gsapijaszko/datalogger/README.md

# yet another datalogger
atmega, sdcard, usb port, DS3231 RTC

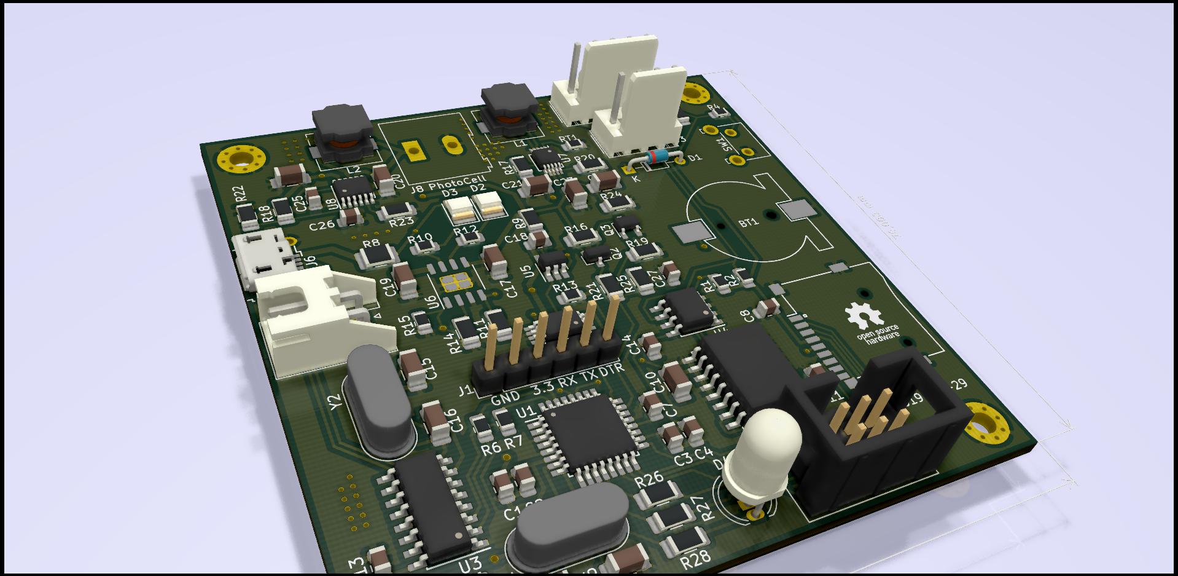
[picture p1: hardware/datalogger.jpg]


work in progress..
