gsapijaszko/datalogger/(list of files, drawings)

Other design files:
hardware/datalogger.dsn
