gsapijaszko/datalogger/hardware/datalogger.kicad_pcb

## KiCad design hardware/datalogger.kicad_pcb (2019-06-12)

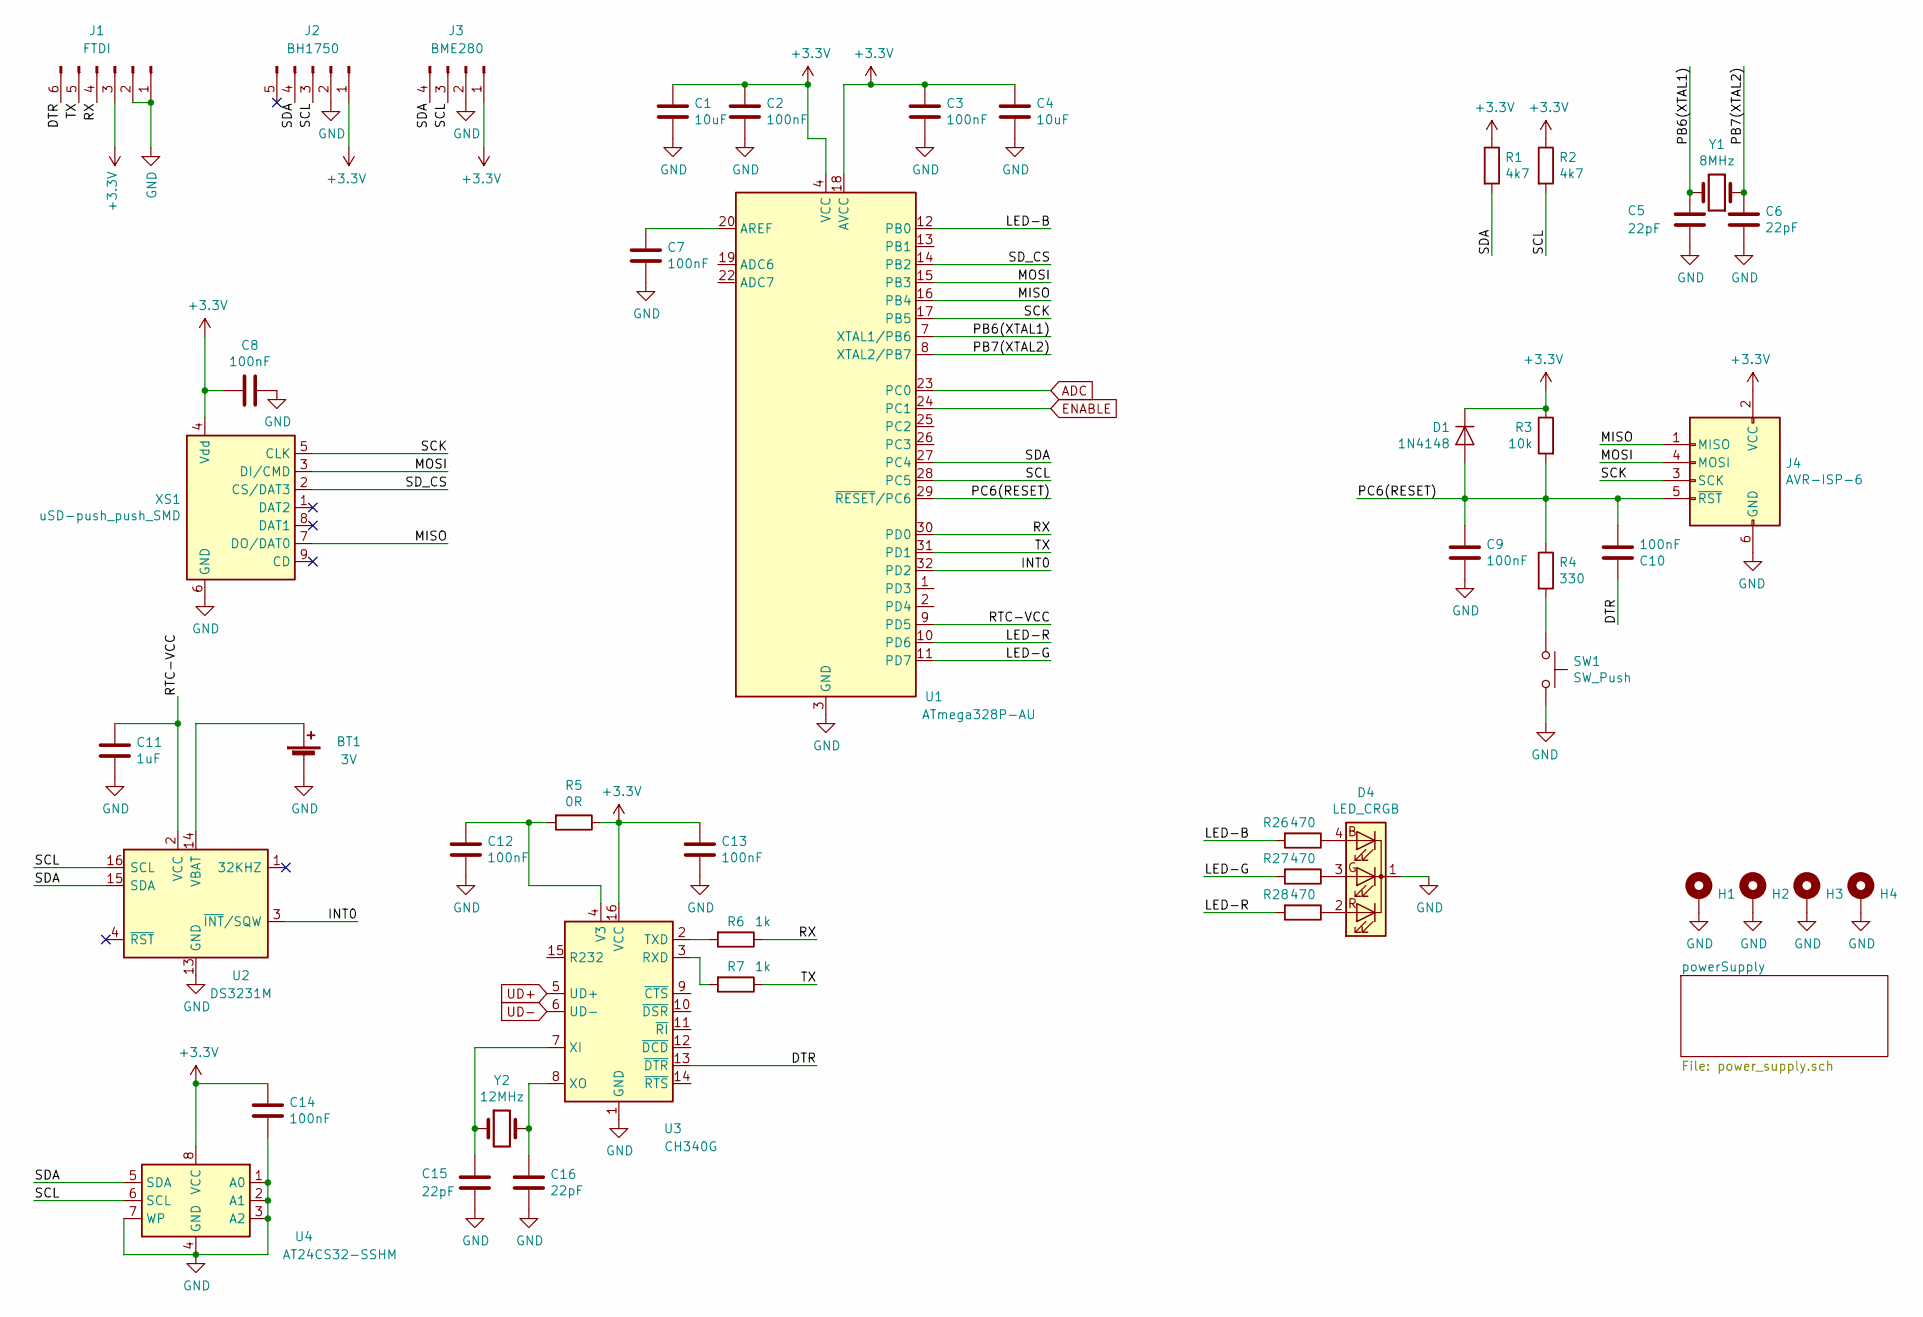
[picture p2: schematic datalogger.sch, field datalogger]

Parts:
BT1: 3V; 1220 Battery Holder, SMD
C1, C4: 10uF; C_0805_2012Metric_Pad1.15x1.40mm_HandSolder
C2, C3, C7, C8, C9, C12, C13, C14: 100nF; C_0805_2012Metric_Pad1.15x1.40mm_HandSolder
C5, C6, C15, C16: 22pF; C_1206_3216Metric_Pad1.42x1.75mm_HandSolder
C10: 100nF; C_1206_3216Metric_Pad1.42x1.75mm_HandSolder
C11: 1uF; C_0805_2012Metric_Pad1.15x1.40mm_HandSolder
D1: 1N4148; D_DO-34_SOD68_P7.62mm_Horizontal
D4: LED_CRGB; LED_D5.0mm-4_RCGB
H1, H2, H3, H4: H; MountingHole_2.7mm_M2.5_Pad_Via
J1: FTDI; PinHeader_1x06_P2.54mm_Vertical
J2: BH1750; Molex_KK-254_AE-6410-05A_1x05_P2.54mm_Vertical
J3: BME280; Molex_KK-254_AE-6410-04A_1x04_P2.54mm_Vertical
J4: AVR-ISP-6; IDC-Header_2x03_P2.54mm_Vertical
R1, R2: 4k7; R_0805_2012Metric_Pad1.15x1.40mm_HandSolder
R3: 10k; R_1206_3216Metric_Pad1.42x1.75mm_HandSolder
R4: 330; R_0805_2012Metric_Pad1.15x1.40mm_HandSolder
R5: 0R; R_0805_2012Metric_Pad1.15x1.40mm_HandSolder
R6, R7: 1k; R_0805_2012Metric_Pad1.15x1.40mm_HandSolder
R26, R27, R28: 470; R_1206_3216Metric_Pad1.42x1.75mm_HandSolder
SW1: SW_Push; SW_Tactile_SKHH_Angled
U1: ATmega328P-AU; TQFP-32_7x7mm_P0.8mm
U2: DS3231M; SOIC-16W_7.5x10.3mm_P1.27mm
U3: CH340G; SOIC-16_3.9x9.9mm_P1.27mm
U4: AT24CS32-SSHM; SOIC-8_3.9x4.9mm_P1.27mm
XS1: uSD-push_push_SMD; Conn_uSDcard
Y1: 8MHz; Crystal_HC49-U_Vertical
Y2: 12MHz; Crystal_HC49-U_Vertical

Connections:
+3V3: C1.1, C2.2, C3.2, C4.1, C8.1, C13.2, C14.1, D1.1 (K), J1.3, J2.1, J3.1, J4.2 (VCC), R1.1, R2.1, R3.1, R5.1, U1.4 (VCC), U1.6 (VCC), U1.18 (AVCC), U3.16 (VCC), U4.8 (VCC), XS1.4 (Vdd); also elsewhere on the board
/DTR: C10.1, J1.6, U3.13 (~DTR)
/INT0: U1.32 (PD2), U2.3 (~INT~/SQW)
/LED-B: R26.2, U1.12 (PB0)
/LED-G: R27.2, U1.11 (PD7)
/LED-R: R28.2, U1.10 (PD6)
/MISO: J4.1 (MISO), U1.16 (PB4), XS1.7 (DO/DAT0)
/MOSI: J4.4 (MOSI), U1.15 (PB3), XS1.3 (DI/CMD)
/PB6(XTAL1): C5.1, U1.7 (XTAL1/PB6), Y1.2
/PB7(XTAL2): C6.1, U1.8 (XTAL2/PB7), Y1.1
/PC6(RESET): C9.1, C10.2, D1.2 (A), J4.5 (~RST), R3.2, R4.1, U1.29 (~RESET~/PC6)
/RTC-VCC: C11.1, U1.9 (PD5), U2.2 (VCC)
/RX: J1.4, R6.1, U1.30 (PD0)
/SCK: J4.3 (SCK), U1.17 (PB5), XS1.5 (CLK)
/SCL: J2.3, J3.3, R2.2, U1.28 (PC5), U2.16 (SCL), U4.6 (SCL)
/SDA: J2.4, J3.4, R1.2, U1.27 (PC4), U2.15 (SDA), U4.5 (SDA)
/SD_CS: U1.14 (PB2), XS1.2 (CS/DAT3)
/TX: J1.5, R7.1, U1.31 (PD1)
ADC: U1.23 (PC0); also elsewhere on the board
ENABLE: U1.24 (PC1); also elsewhere on the board
GND: BT1.2 (-), C1.2, C2.1, C3.1, C4.2, C5.2, C6.2, C7.2, C8.2, C9.2, C11.2, C12.1, C13.1, C14.2, C15.2, C16.2, D4.1 (K), H1.1, H2.1, H3.1, H4.1, J1.1, J1.2, J2.2, J3.2, J4.6 (GND), SW1.2, U1.3 (GND), U1.5 (GND), U1.21 (GND), U2.5 (GND), U2.6 (GND), U2.7 (GND), U2.8 (GND), U2.9 (GND), U2.10 (GND), U2.11 (GND), U2.12 (GND), U2.13 (GND), U3.1 (GND), U4.1 (A0), U4.2 (A1), U4.3 (A2), U4.4 (GND), U4.7 (WP), XS1.6 (GND); also elsewhere on the board
unnamed: BT1.1 (+), U2.14 (VBAT)
unnamed: C7.1, U1.20 (AREF)
unnamed: C12.2, R5.2, U3.4 (V3)
unnamed: C15.1, U3.7 (XI), Y2.1
unnamed: C16.1, U3.8 (XO), Y2.2
unnamed: D4.2 (RA), R28.1
unnamed: D4.3 (GA), R27.1
unnamed: D4.4 (BA), R26.1
unnamed: R4.2, SW1.1
unnamed: R6.2, U3.2 (TXD)
unnamed: R7.2, U3.3 (RXD)
UD+: U3.5 (UD+); also elsewhere on the board
UD-: U3.6 (UD-); also elsewhere on the board

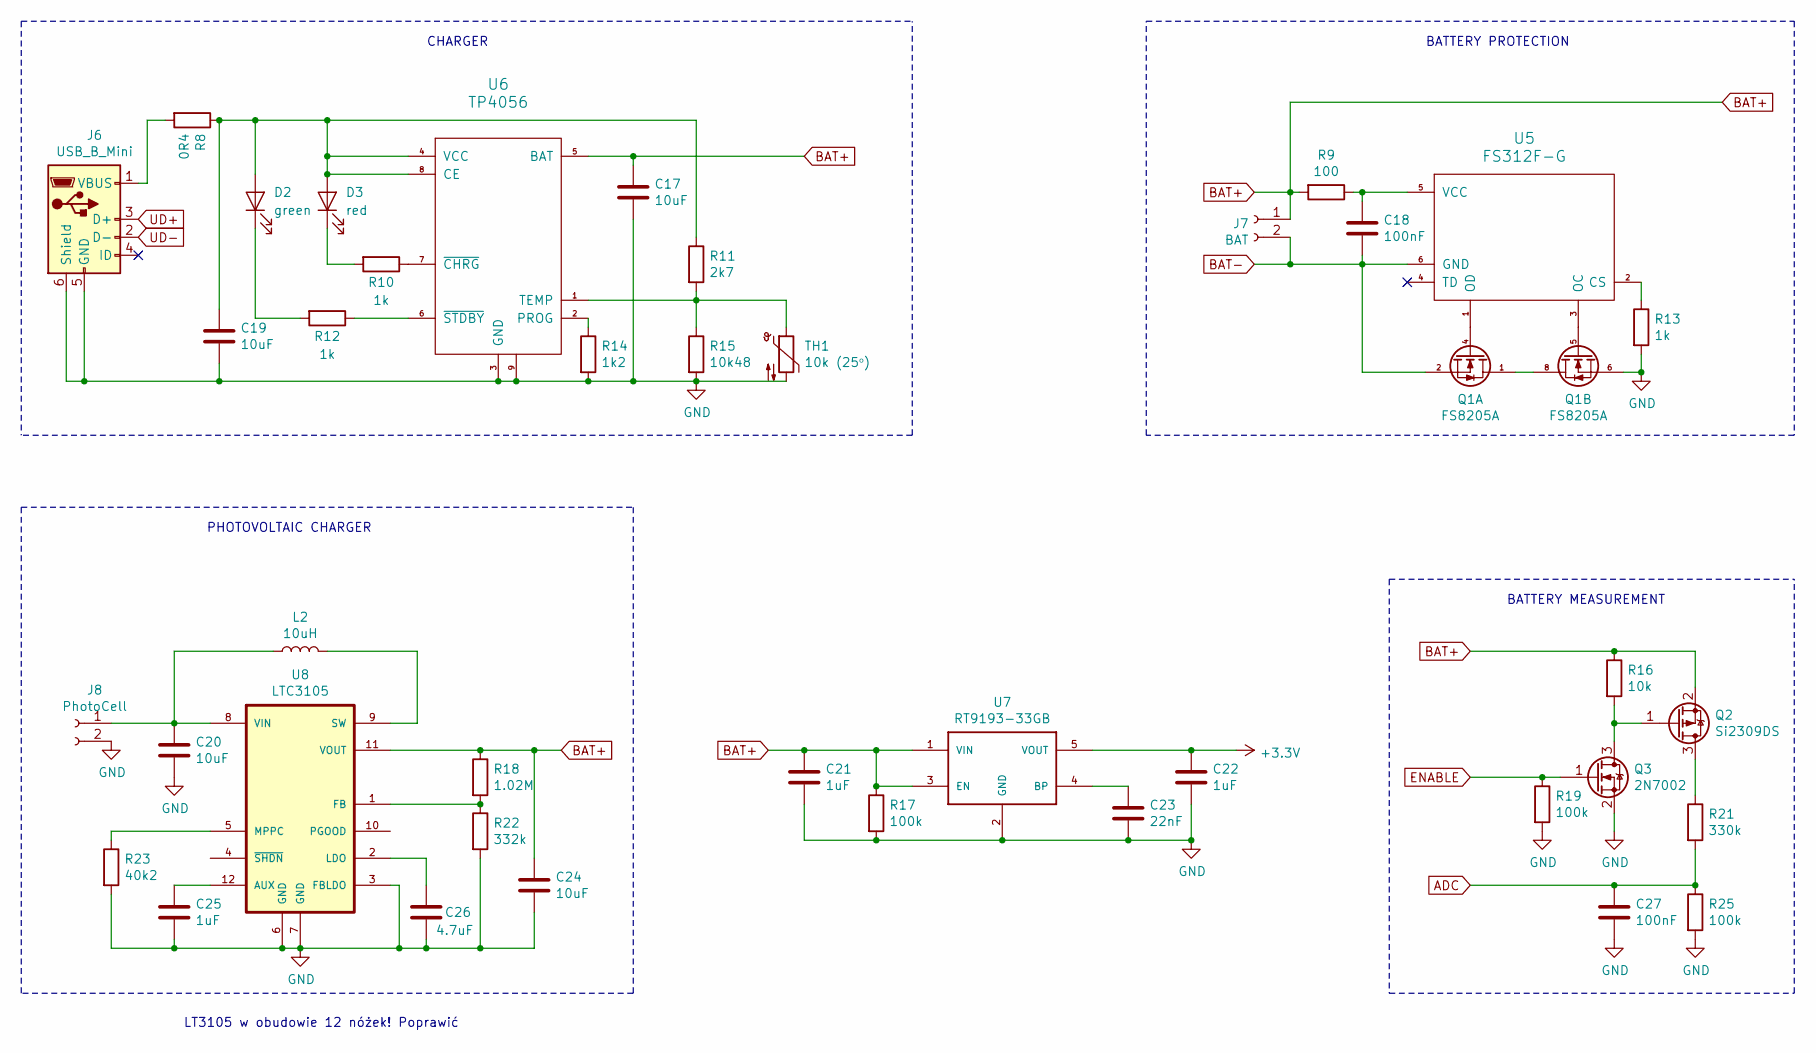
[picture p3: schematic power_supply.sch, field datalogger]

Parts:
C17, C19, C20, C24: 10uF; C_1206_3216Metric_Pad1.42x1.75mm_HandSolder
C18, C27: 100nF; C_0805_2012Metric_Pad1.15x1.40mm_HandSolder
C21, C22: 1uF; C_0805_2012Metric_Pad1.15x1.40mm_HandSolder
C23: 22nF; C_0805_2012Metric_Pad1.15x1.40mm_HandSolder
C25: 1uF; C_0805_2012Metric
C26: 4.7uF; C_0805_2012Metric
D2: green; LED_1210_3225Metric_Pad1.42x2.65mm_HandSolder
D3: red; LED_1210_3225Metric_Pad1.42x2.65mm_HandSolder
J6: USB_B_Mini; USB_Micro-B_Wuerth_629105150521
J7: BAT; JST_XH_S02B-XH-A_1x02_P2.50mm_Horizontal
J8: PhotoCell; TerminalBlock_Altech_AK300-2_P5.00mm
L2: 10uH; L_7.3x7.3_H4.5
Q1: FS8205A; TSSOP-8_4.4x3mm_P0.65mm
Q2: Si2309DS; SOT-23
Q3: 2N7002; TSOT-23
R8: 0R4; R_1210_3225Metric_Pad1.42x2.65mm_HandSolder
R9: 100; R_1206_3216Metric_Pad1.42x1.75mm_HandSolder
R10, R12, R13: 1k; R_0805_2012Metric_Pad1.15x1.40mm_HandSolder
R11: 2k7; R_1206_3216Metric_Pad1.42x1.75mm_HandSolder
R14: 1k2; R_1206_3216Metric_Pad1.42x1.75mm_HandSolder
R15: 10k48; R_0805_2012Metric_Pad1.15x1.40mm_HandSolder
R16: 10k; R_1206_3216Metric_Pad1.42x1.75mm_HandSolder
R17, R19, R25: 100k; R_1206_3216Metric_Pad1.42x1.75mm_HandSolder
R18: 1.02M; R_1206_3216Metric_Pad1.42x1.75mm_HandSolder
R21: 330k; R_1206_3216Metric_Pad1.42x1.75mm_HandSolder
R22: 332k; R_1206_3216Metric_Pad1.42x1.75mm_HandSolder
R23: 40k2; R_1206_3216Metric_Pad1.42x1.75mm_HandSolder
TH1: 10k (25ᵒ); R_1218_3246Metric_Pad1.22x4.75mm_HandSolder
U5: FS312F-G; SOT-23-6_Handsoldering
U6: TP4056; HSOP-8-1EP_3.9x4.9mm_P1.27mm_EP2.41x3.1mm_ThermalVias
U7: RT9193-33GB; SOT-23-5_HandSoldering
U8: LTC3105; MSOP-12_3x4mm_P0.65mm

Connections:
+3V3: C22.1, U7.5 (VOUT); also elsewhere on the board
ADC: C27.1, R21.2, R25.1; also elsewhere on the board
BAT+: C17.1, C21.1, C24.1, J7.1, Q2.2 (S), R9.2, R16.1, R17.1, R18.1, U6.5 (BAT), U7.1 (VIN), U7.3 (EN), U8.11 (VOUT)
BAT-: C18.2, J7.2, Q1.2 (S1), U5.6 (GND)
ENABLE: Q3.1 (G), R19.1; also elsewhere on the board
GND: C17.2, C19.2, C20.2, C21.2, C22.2, C23.2, C24.2, C25.2, C26.2, C27.2, J6.5 (GND), J6.6 (Shield), J8.2, Q1.6 (S1), Q3.2 (S), R13.2, R14.2, R15.2, R17.2, R19.2, R22.2, R23.2, R25.2, TH1.2, U6.3 (GND), U6.9, U7.2 (GND), U8.3 (FBLDO), U8.6 (GND), U8.7 (GND); also elsewhere on the board
unnamed: C18.1, R9.1, U5.5 (VCC)
unnamed: C19.1, D2.2 (A), D3.2 (A), R8.1, R11.1, U6.4 (VCC), U6.8 (CE)
unnamed: C20.1, J8.1, L2.1, U8.8 (VIN)
unnamed: C23.1, U7.4 (BP)
unnamed: C25.1, U8.12 (AUX)
unnamed: C26.1, U8.2 (LDO)
unnamed: D2.1 (K), R12.2
unnamed: D3.1 (K), R10.2
unnamed: J6.1 (VBUS), R8.2
unnamed: L2.2, U8.9 (SW)
unnamed: Q1.1 (D), Q1.8 (D)
unnamed: Q1.4 (G2), U5.1 (OD)
unnamed: Q1.5 (G2), U5.3 (OC)
unnamed: Q2.1 (G), Q3.3 (D), R16.2
unnamed: Q2.3 (D), R21.1
unnamed: R10.1, U6.7 (~CHRG)
unnamed: R11.2, R15.1, TH1.1, U6.1 (TEMP)
unnamed: R12.1, U6.6 (~STDBY)
unnamed: R13.1, U5.2 (CS)
unnamed: R14.1, U6.2 (PROG)
unnamed: R18.2, R22.1, U8.1 (FB)
unnamed: R23.1, U8.5 (MPPC)
UD+: J6.3 (D+); also elsewhere on the board
UD-: J6.2 (D-); also elsewhere on the board

Notes on the sheet:
CHARGER
BATTERY PROTECTION
BATTERY MEASUREMENT
PHOTOVOLTAIC CHARGER
LT3105 w obudowie 12 nóżek! Poprawić

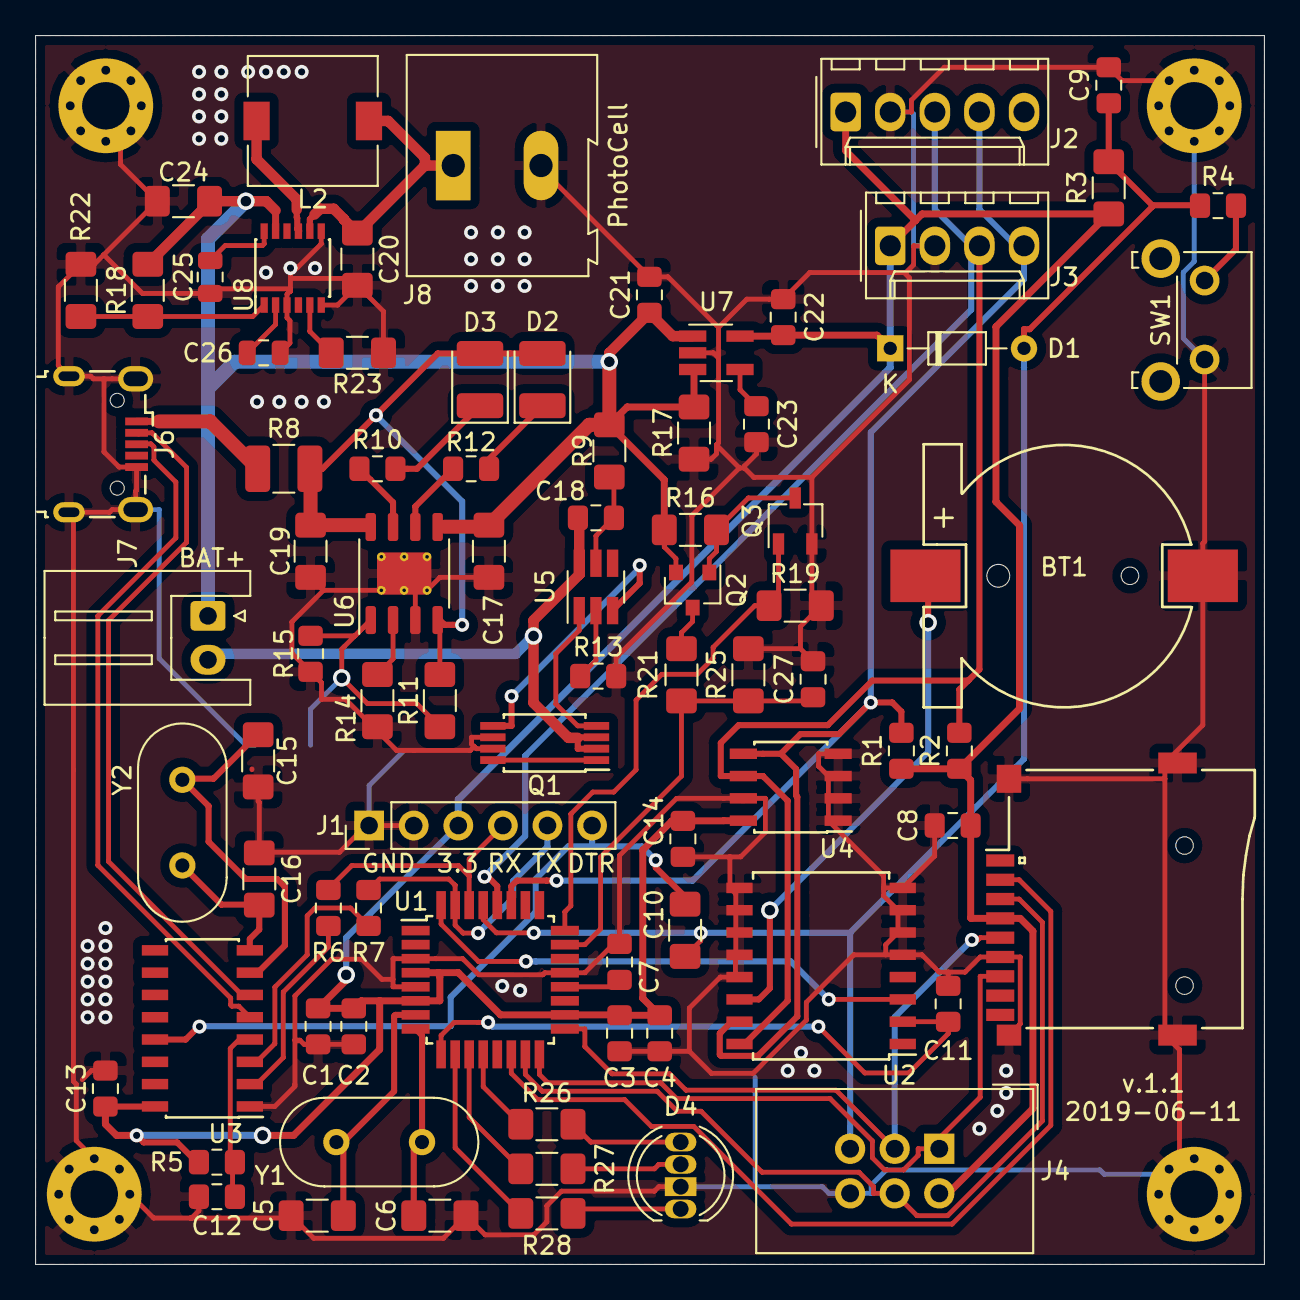
[picture p4: board datalogger.kicad_pcb from above]

Board: 2 copper layers, 70.0 x 70.0 mm, 86 parts (1 on the bottom side), 58 nets.
