gsapijaszko/datalogger/(commit log)

2019-04-01 Update LICENSE, README.md, and 31 more files...
    [datalogger.kicad_pcb, datalogger.sch, power_supply.sch]
2019-04-01 Update datalogger-rescue.dcm, datalogger-rescue.lib, and 3 more files...
    [datalogger.kicad_pcb]
2019-04-02 Update datalogger-cache.lib, datalogger.bak, and 7 more files...
    [datalogger.kicad_pcb, datalogger.sch, power_supply.sch]
2019-04-04 Update datalogger.dsn, datalogger.jpg, and 6 more files...
    [datalogger.dsn, datalogger.kicad_pcb]
2019-04-05 Update datalogger-cache.lib, datalogger-rescue.dcm, and 8 more files...
    [datalogger.kicad_pcb, datalogger.sch, power_supply.sch]
2019-04-06 Update _autosave-datalogger.kicad_pcb, datalogger.jpg, and 2 more files...
    [datalogger.kicad_pcb]
2019-04-13 Update datalogger-cache.lib, datalogger-rescue.lib, and 11 more files...
    [datalogger.dsn, datalogger.kicad_pcb, datalogger.sch, power_supply.sch]
2019-04-13 Update datalogger.jpg, datalogger.kicad_pcb, and 2 more files...
    [datalogger.kicad_pcb]
2019-04-14 Update datalogger.kicad_pcb and datalogger.kicad_pcb-bak
    [datalogger.kicad_pcb]
2019-04-18 Update datalogger.kicad_pcb, datalogger.kicad_pcb-bak, and fp-info-cache
    [datalogger.kicad_pcb]
2019-04-26 Update datalogger-cache.lib, datalogger-rescue.bck, and 11 more files...
    [datalogger.dsn, datalogger.kicad_pcb, datalogger.sch, power_supply.sch]
2019-04-28 Update datalogger-cache.lib, datalogger.bak, and 6 more files...
    [datalogger.kicad_pcb, datalogger.sch, power_supply.sch]
2019-04-28 Update datalogger.kicad_pcb, datalogger.kicad_pcb-bak, and datalogger.pro
    [datalogger.kicad_pcb]
2019-04-29 Update datalogger-cache.lib, datalogger.kicad_pcb, and 19 more files...
    [datalogger-B_Cu.gbr, datalogger-B_Mask.gbr, datalogger-B_Paste.gbr, datalogger-B_SilkS.gbr, datalogger-Edge_Cuts.gbr, datalogger-F_Cu.gbr, datalogger-F_Mask.gbr, datalogger-F_Paste.gbr]
2019-04-29 v.1.0 ready for PCB manufacturing
    [datalogger-B_Cu.gbr, datalogger-B_Mask.gbr, datalogger-B_Paste.gbr, datalogger-B_SilkS.gbr, datalogger-Edge_Cuts.gbr, datalogger-F_Cu.gbr, datalogger-F_Mask.gbr, datalogger-F_Paste.gbr]
2019-06-06 Update datalogger-cache.lib, datalogger.bak, and 20 more files...
    [datalogger-B_Cu.gbr, datalogger-B_Mask.gbr, datalogger-B_Paste.gbr, datalogger-B_SilkS.gbr, datalogger-Edge_Cuts.gbr, datalogger-F_Cu.gbr, datalogger-F_Mask.gbr, datalogger-F_Paste.gbr]
2019-06-11 Change from buck-bost converter to 3.3V LDO
    [datalogger-B_Cu.gbr, datalogger-B_Mask.gbr, datalogger-B_Paste.gbr, datalogger-B_SilkS.gbr, datalogger-Edge_Cuts.gbr, datalogger-F_Cu.gbr, datalogger-F_Mask.gbr, datalogger-F_Paste.gbr]
2019-06-12 v. 1.1, sent to PCB
    [datalogger-B_Cu.gbr, datalogger-B_Mask.gbr, datalogger-B_Paste.gbr, datalogger-B_SilkS.gbr, datalogger-Edge_Cuts.gbr, datalogger-F_Cu.gbr, datalogger-F_Mask.gbr, datalogger-F_Paste.gbr]
